jackmaxg/small_laser_supply/README.md

# Swept Source Laser Driver

A small 5v 3mA constant current laser diode power supply for the Physical Optics and Electronics lab, MIT RLE.

Jackson Gray

jackmaxg@mit.edu

Summer '18 UROP

Schematic

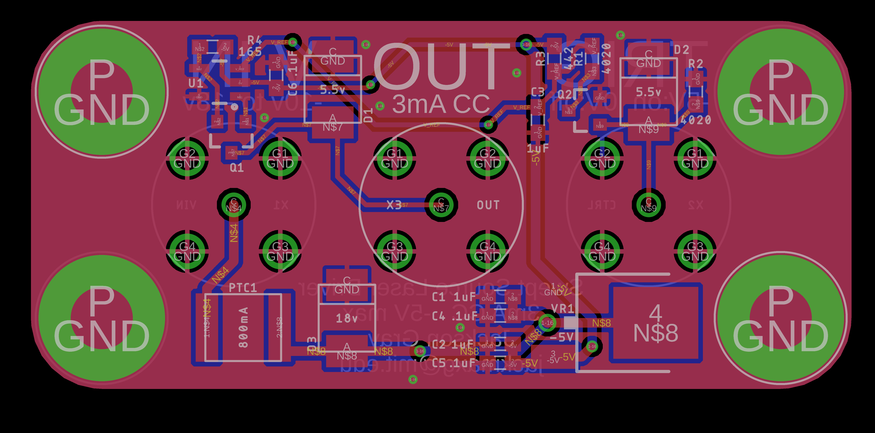
[picture p1: images/boardpic.png]
Board


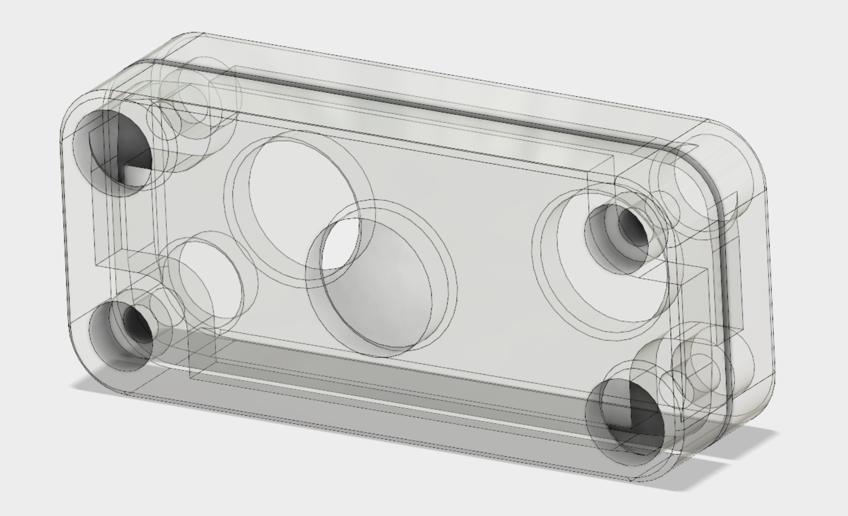
[picture p2: images/case_cad_pic.PNG]
Case Cad
