jackmaxg/small_laser_supply/case/OutPlateBdy.stl

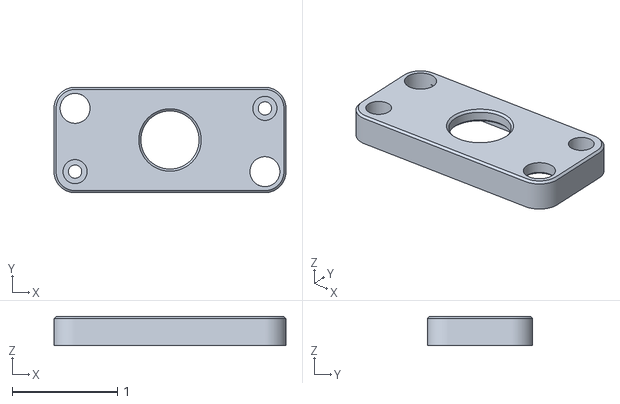
[picture p3: CAD file, 2018-06-19]
case/OutPlateBdy.stl
2.20 x 1.00 x 0.276
