jackmaxg/small_laser_supply/case/InPlateBody.stl

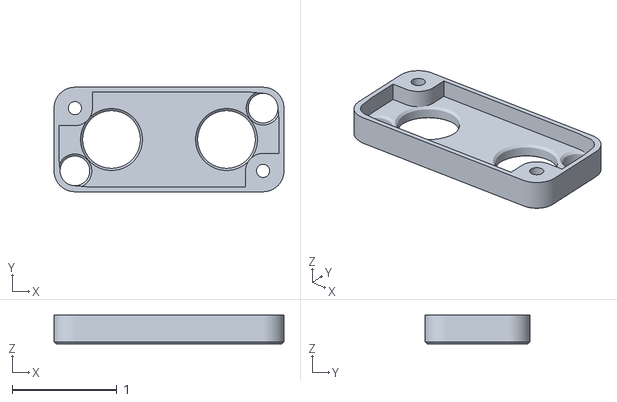
[picture p4: CAD file, 2018-06-19]
case/InPlateBody.stl
2.20 x 1.00 x 0.276
