jackmaxg/small_laser_supply/case/PCB_Case v2.step

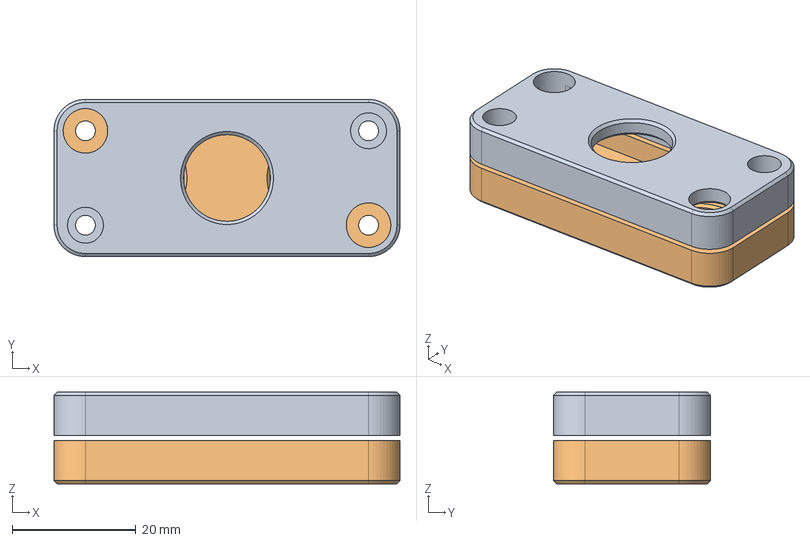
[picture p5: CAD file, 2018-06-19]
case/PCB_Case v2.step
55.9 x 25.4 x 14.8 mm
