jackmaxg/small_laser_supply/case/PCB_Case.step

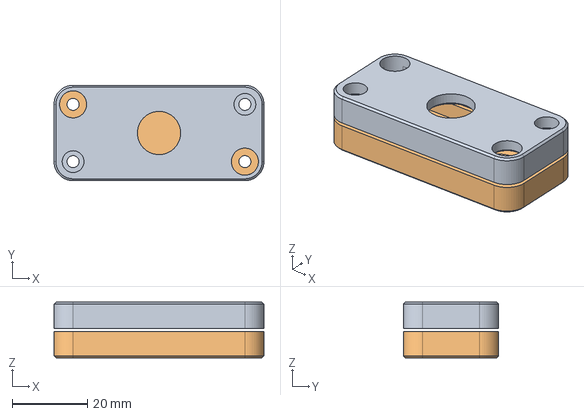
[picture p6: CAD file, 2018-06-08, an earlier design]
case/PCB_Case.step
55.9 x 25.4 x 14.8 mm
