jackmaxg/small_laser_supply/sim/SupplySimulationNegative.asc

C1: cap; 1µF
D1: schottky; NSR20F30NXT5G
Q1: npn; 2N3904
Q2: npn; 2N3904
R1: res; 442
R2: res; 4020
R3: res; 165
R4: res; 100
U1: LT6003
V1: voltage; 5
V2: voltage; PULSE(0 1 .025 .00001 .00001 .05 .1 10)
Named nets: 0, -5V
.tran .3
