jackmaxg/small_laser_supply/sim/SupplySimulation.asc

C1: cap; 1µF
D1: zener; BZX84C6V2L
D2: zener; BZX84C6V2L
D3: schottky; NSR20F30NXT5G
M1: nmos; BSC030N03MS
Q1: pnp; 2N3906
R1: res; 442
R2: res; 4.02K; tol=1
R3: res; 165; tol=1
R4: res; 10K
R5: res; 100
R6: res; 1
R7: res; 1
U1: LT6003
V1: voltage; PULSE(0 5 .05 .001 .001 .05 .1 10)
V2: voltage; 5V
Named nets: 0, 5V, TRIG
.tran .2
