jackmaxg/small_laser_supply/small_laser_supply_eagleproj/small_laser_supply/small_laser_supply.brd

## EAGLE design small_laser_supply_eagleproj/small_laser_supply/small_laser_supply.brd (2018-06-19)

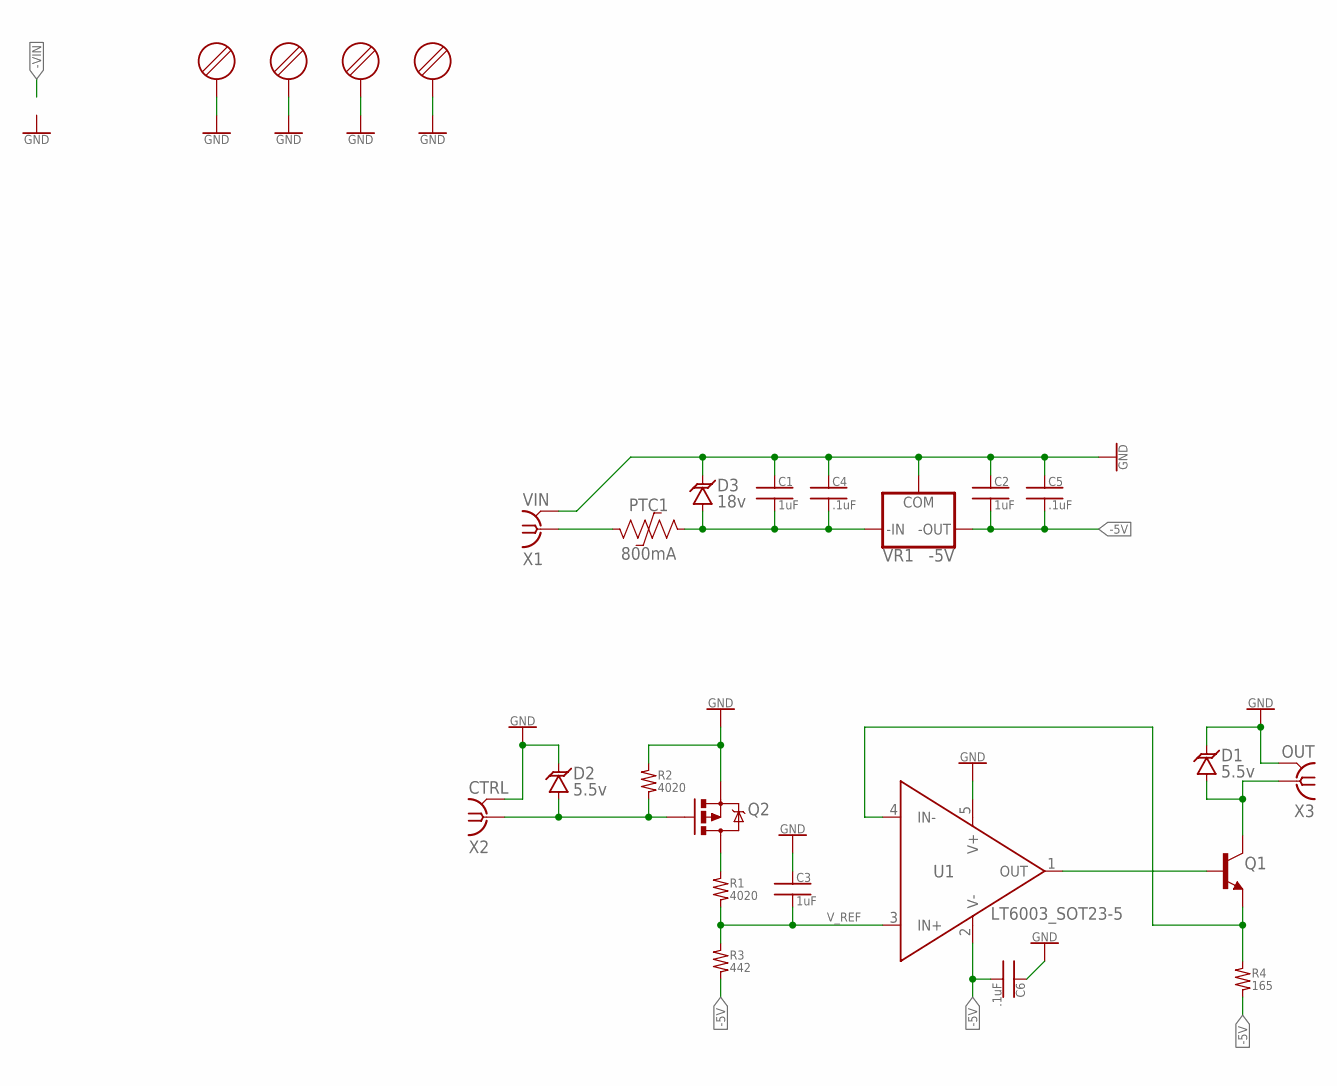
[picture p7: schematic small_laser_supply.sch]

Parts:
C1, C2, C3: 1uF; 0603
C4, C5, C6: .1uF; 0603
D1, D2: 5.5v; DO-214AA
D3: 18v; DO-214AA
MH1, MH2, MH3, MH4: THREADED_INSERT_M3; 7466003R
PTC1: 800mA; 2SMD_PTC
Q1: BJT_NPN_SOT23-3; SOT23-3
Q2: MOSFET_P-CHANNEL_SOT23-3; SOT23-3
R1, R2: 4020; 0603
R3: 442; 0603
R4: 165; 0603
U1: LT6003_SOT23-5; SOT23-5
VR1: -5V; DPAK
X1: VIN; 5-1634503-1
X2: CTRL; 5-1634503-1
X3: OUT; 5-1634503-1

Connections:
-5V: C2.2, C5.2, C6.2, R3.2, R4.2, U1.2 (V-), VR1.3 (OUT)
GND: C1.1, C2.1, C3.1, C4.1, C5.1, C6.1, D1.C, D2.C, D3.C, MH1.P, MH2.P, MH3.P, MH4.P, Q2.2 (S), R2.1, U1.5 (V+), VR1.1 (GND), X1.G1 (GND), X1.G2 (GND), X1.G3 (GND), X1.G4 (GND), X2.G1 (GND), X2.G2 (GND), X2.G3 (GND), X2.G4 (GND), X3.G1 (GND), X3.G2 (GND), X3.G3 (GND), X3.G4 (GND)
unnamed: Q1.1 (B), U1.1 (OUT)
unnamed: Q1.2 (E), R4.1, U1.4 (IN-)
unnamed: Q2.3 (D), R1.1
unnamed: PTC1.1, X1.C (1)
unnamed: D1.A, Q1.3 (C), X3.C (1)
unnamed: C1.2, C4.2, D3.A, PTC1.2, VR1.4 (IN)
unnamed: D2.A, Q2.1 (G), R2.2, X2.C (1)
V_REF: C3.2, R1.2, R3.1, U1.3 (IN+)

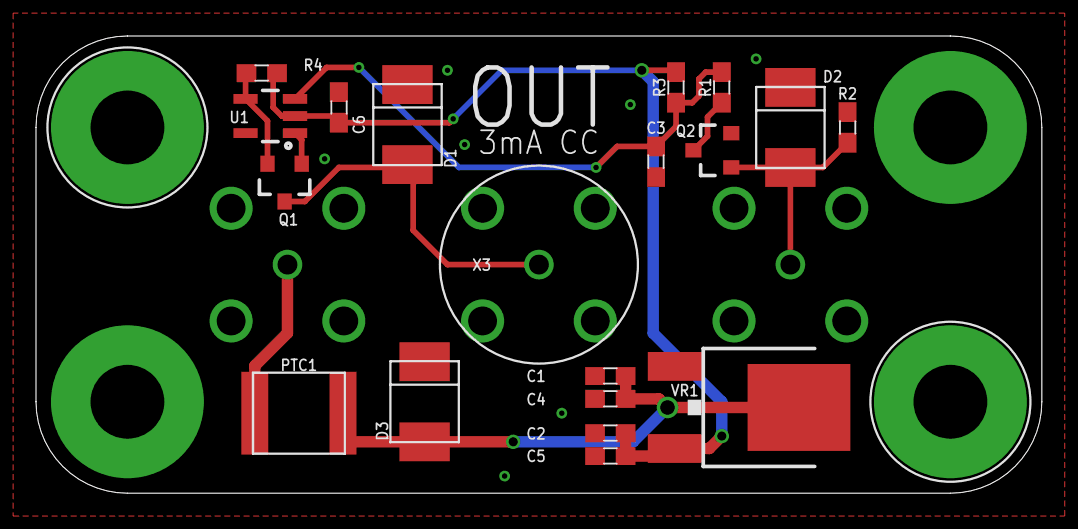
[picture p8: board small_laser_supply.brd from above]

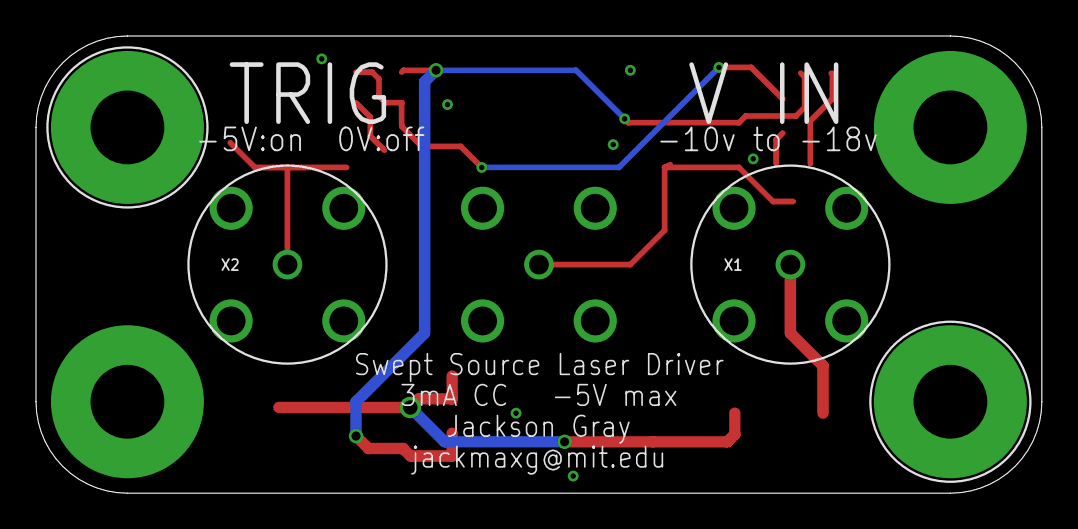
[picture p9: board small_laser_supply.brd from below]

Board: 2 copper layers, 55.9 x 25.4 mm, 25 parts (4 on the bottom side), 10 nets.
