jackmaxg/small_laser_supply/(commit log)

2018-06-04 Added new project files, schematic, and the project library with a few things in it
    [small_laser_supply.sch]
2018-06-04 Added a board with the general parts layout, and a general layout of the schematic as well.
    [small_laser_supply.brd, small_laser_supply.sch]
2018-06-04 Added a few more bits to the lib, opamp, resistor/capacitor, and a pnp bjt
2018-06-05 Simulated the circuit in LTSpice
2018-06-05 Nearly finished the schematic and initial board layout (before routing traces)
    [small_laser_supply.brd, small_laser_supply.sch]
2018-06-05 added a new linear voltage reg and added 0805 package CAP/RES
2018-06-05 lots more work on the board and schematic before realizing the laser diode is actually backwards and we need to pull current out of ground
    [small_laser_supply.brd, small_laser_supply.sch]
2018-06-06 simulated the negative voltage circuit version.
2018-06-06 Fixed version of the schematic seems to be finished
    [small_laser_supply.brd, small_laser_supply.sch]
2018-06-06 Started and probably finished laying out the board and routing traces, need to generate gerber files next.
    [small_laser_supply.brd, small_laser_supply.sch]
2018-06-06 Took a couple images of the board and schematic and added them to the README.md file
    [small_laser_supply.sch]
2018-06-06 Moved the big chunks to the center of the schematic, and took a better picture of it
    [small_laser_supply.sch]
2018-06-07 generated the cam and gerbers to send to 3pcb, added .cam files as BINARY to .gitattributes
2018-06-07 stuck a resistor across the pfet's gate last min, updated the board and images and gerbers and such
    [small_laser_supply.brd, small_laser_supply.sch]
2018-06-07 fixed an issue with too small of vias, updated board and re-gerber-ficated.
    [small_laser_supply.brd]
2018-06-07 added the BOM
    [SLS BOM Purchase.xlsx, SLS BOM.xlsx]
2018-06-08 Created a case for the pcb in cad, and generated two stls for both plates. Made step and stl file types binary in gitattributes
    [InPlateBody.stl, OutPlateBdy.stl, PCB_Case.step]
2018-06-08 Tweaked the readme.md bc cad image wasn't showing up, think it has to do with capitalized filetype extensions
2018-06-08 updated the case pic
2018-06-19 Tweaks following the build of the first few boards, this is mostly minor dimensional fixes here and there. Also fixed a bom issue, one of the parts came on a giant reel instead of tape.
    [InPlateBody.stl, OutPlateBdy.stl, PCB_Case v2.step, SLS BOM Purchase.xlsx, SLS BOM.csv, SLS BOM.xlsx, small_laser_supply.brd, small_laser_supply.sch]
